SolarTrackers/SolarTrackerProject/README.md

# SolarTrackerProject
We are two student at Polytech Orleans, we created a solar tracker from scratch
