SolarTrackers/SolarTrackerProject/Final presentation 26 Avril 2024.pdf

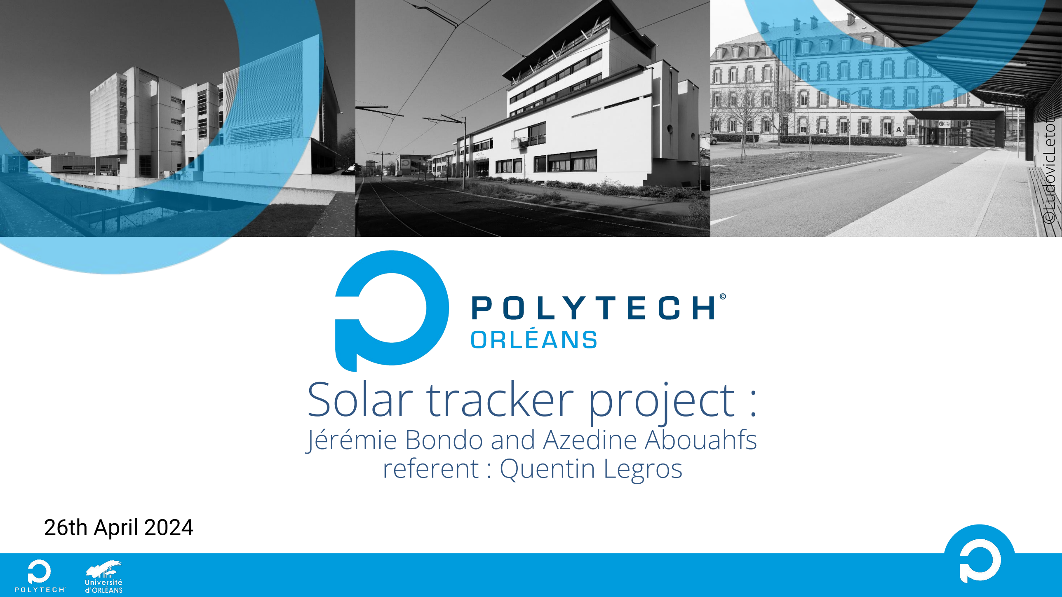
[picture p1: page 1]

1

## ©LudovicLetot

## 26th April 2024

# Solar tracker project :

# Jérémie Bondo and Azedine Abouahfs referent : Quentin Legros

2

## Friday 26th April 2024

# Contents

# -Project’s summary

# -Technical part

# -Technical solutions

# - Involvement of each member

# -Conclusion

# -Demonstration

# Context

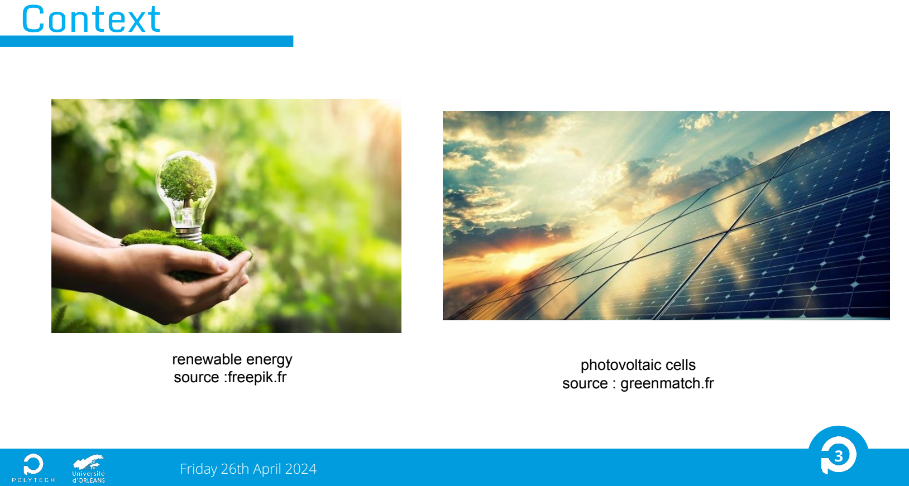
[picture p2: page 3]

3

photovoltaic cells
source : greenmatch.fr

renewable energy
source :freepik.fr

# Contexts

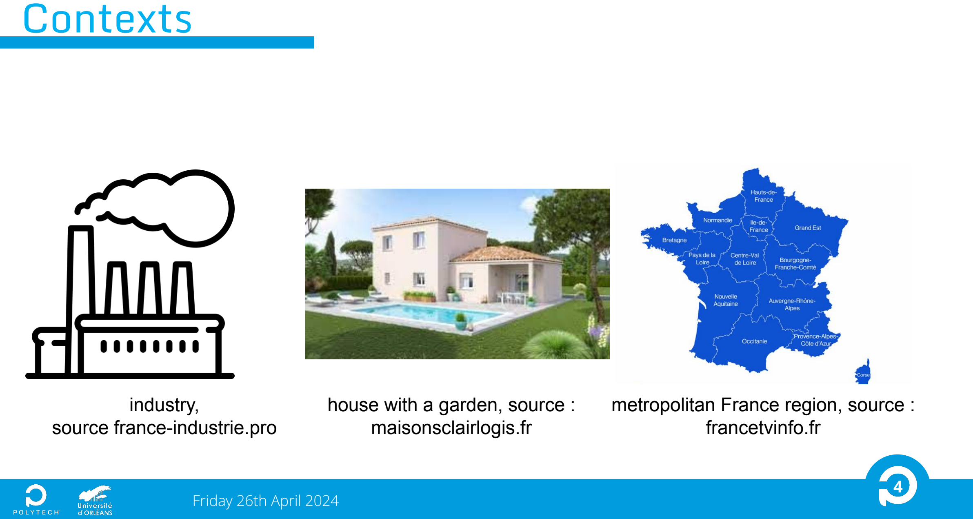
[picture p3: page 4]

4

industry,

### source france-industrie.pro

### metropolitan France region, source : francetvinfo.fr

### house with a garden, source : maisonsclairlogis.fr

5

# Last year project

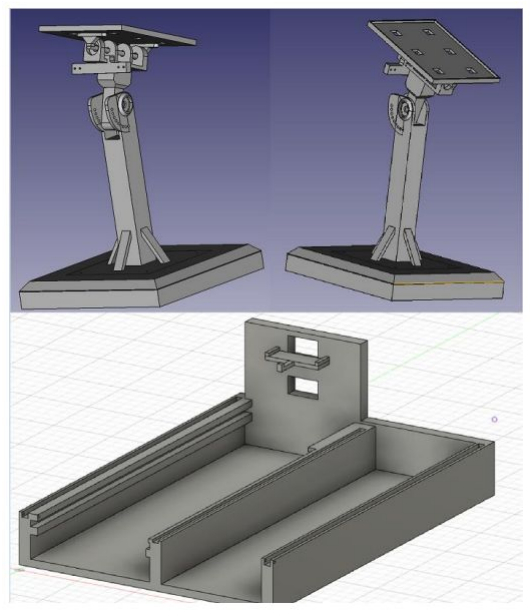
[picture p4: figure]

### view of the 3D models of the 2022-2023 solar tracker project group

# We were able to recover their : -documents - photovoltaic cells

- tracker.

6

# Objectives

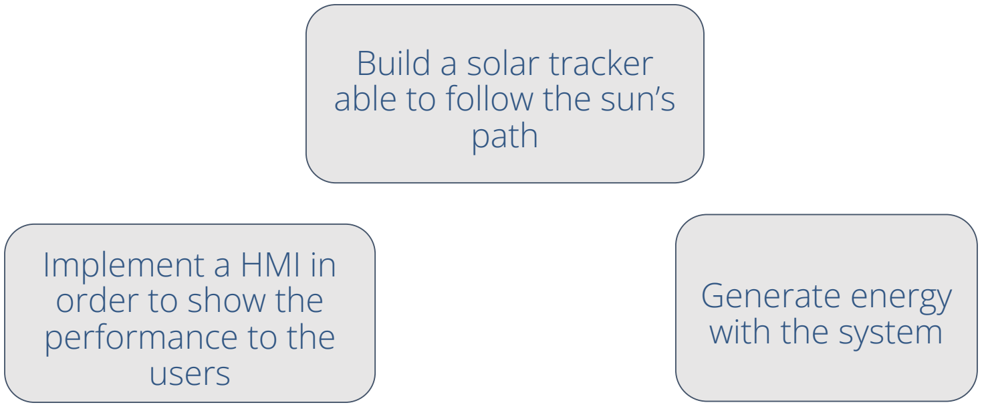
[picture p5: figure]
Build a solar tracker able to follow the sun’s path; Generate energy with the system; Implement a HMI in order to show the performance to the users
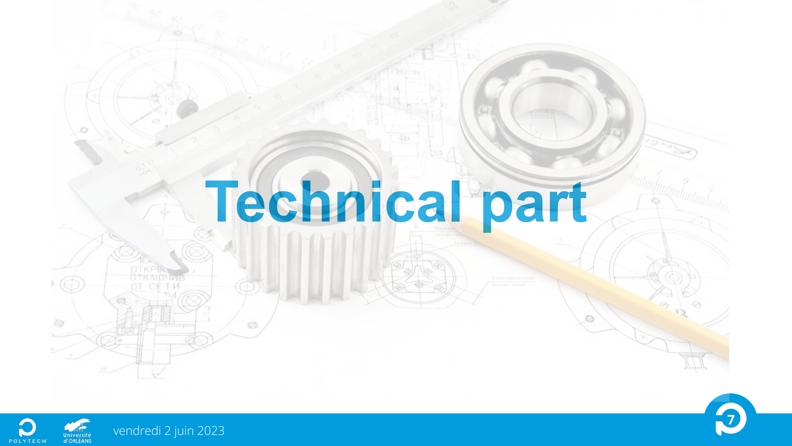
[picture p6: page 7]

7

## vendredi 2 juin 2023

# Technical part

8

# Technical part : What is a solar tracker

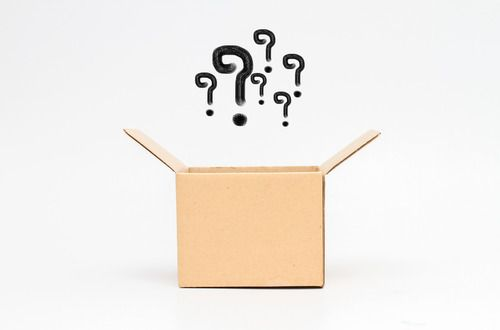
[picture p7: figure]

### mediascol.al

9

# Technical part : What is a solar tracker

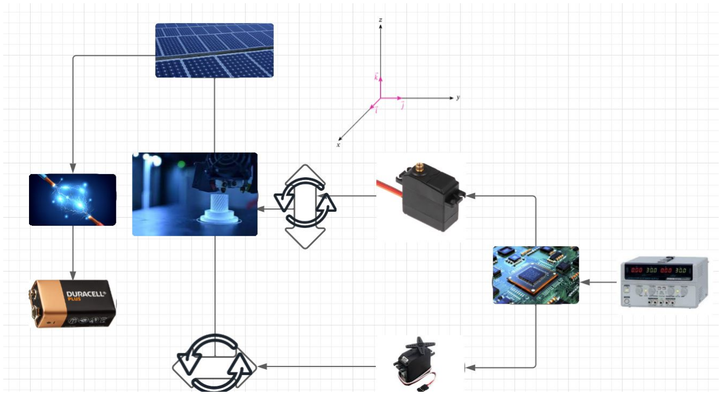
[picture p8: figure]

10

# Features of our project

Features | Assessment criteria

Level of
appreciation

Acceptation
limit
Tracking Precision | - Angle of rotation | 110 degrees around the West/East axis | ± 5 degrees
Energy Production | - Performance of the cells | 0,5W/panel | -0,15W/panel
Resists to challenging weather conditions | -snow, rain, wind -temperature -humidity | -5°C - 40°C 40% - 70%

Ease of Installation
and control
- Datasheet

Carry/Protect the
sensors and the
microcontroller
- Structural
stability
- Durability

PLA

6 months -1year

# Technical Solutions : Measures

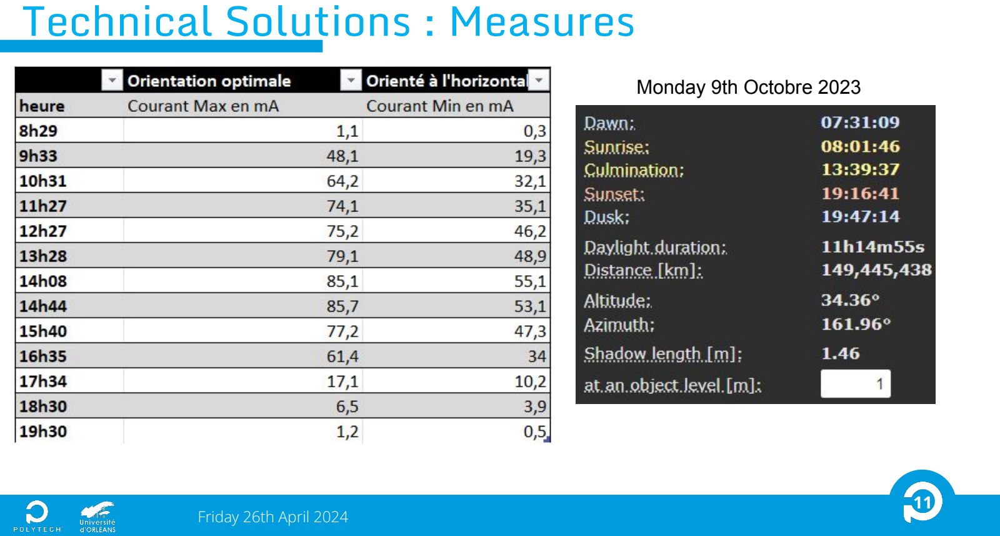
[picture p9: page 11]

11

### Monday 9th Octobre 2023

12

# Technical solutions

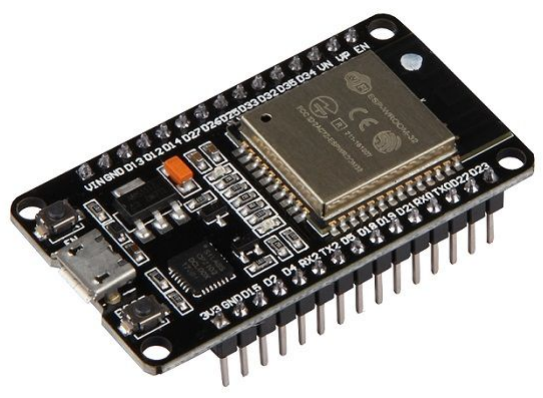
[picture p10: figure]

Esp32

Power supply | 5V-3,3 V
Consumption | Max 50mA

Programming
language

C/C++

Price | 12€
Weight | 7g

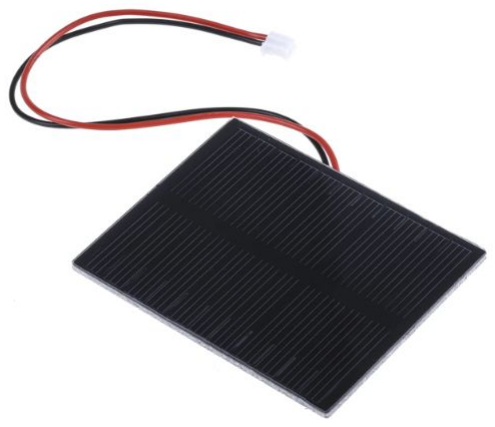
[picture p11: figure]

Photovoltaic plates

Power rating | 0.5W
Current | 100 mA
Dimensions | 70x55x3mm
Price | 3,3€
Weight | 20g

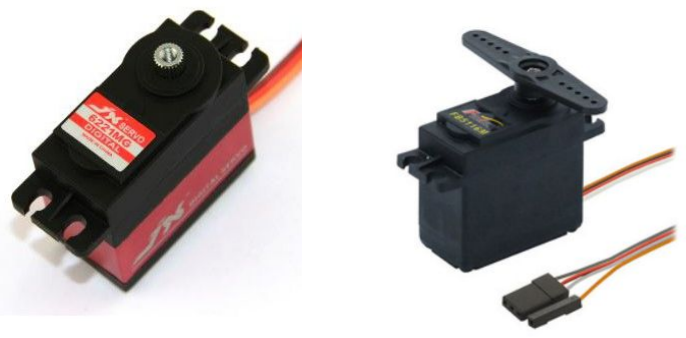
[picture p12: figure]

Servomoteur

Tension | 4,8 - 6,6V
Torque | 15kg.cm | 10kg.cm

Rotation
angle
180° | 280°
Price | 17€ | 14,65€
Weight | 50g | 65

# Components

Figure : esp32 (gotronic.fr) | Figure : Photovoltaic plates
(Seeedstudio.com)

Figure : Servo-Motor
(Robot-maker.com)

Servo-Motor, source :

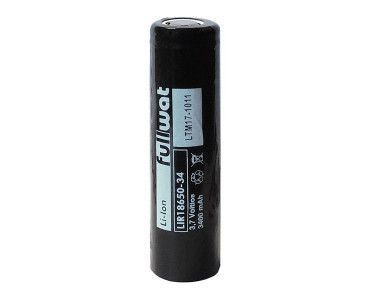
[picture p13: figure]

Figure : Battery LI-ION | go-tronic.com
(Go-tronic.fr)

Battery Li-Ion

Tension | 3,7V
Capacity | 3400 mAh
Type | Lithium-Ion
Rechargeable | Yes
Weight | 46g

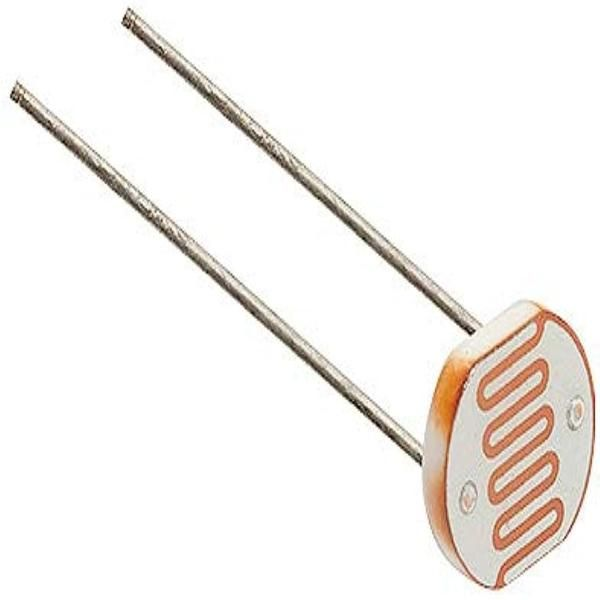
[picture p14: figure]

13

# Technical solutions

# Components

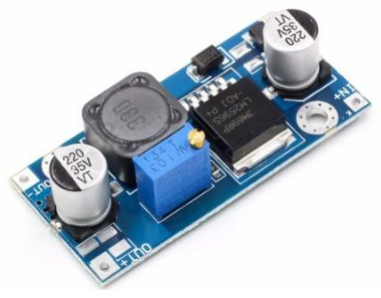
[picture p15: figure]

Voltage regulator DC-DC

Input Voltage | 3,2V - 42V
Output Voltage | 1,25V -35V
Output current | 3A (Max)
Rendement | 92%
Price | 0,6€

Ball bearing

Inside diameter 60 mm

outside
diameter

### 95 mm

Price | 19.34€
Weight | 200g

Figure : Ball bearing (rs-online)

Figure : Voltage regulator (Aliexpress.com)

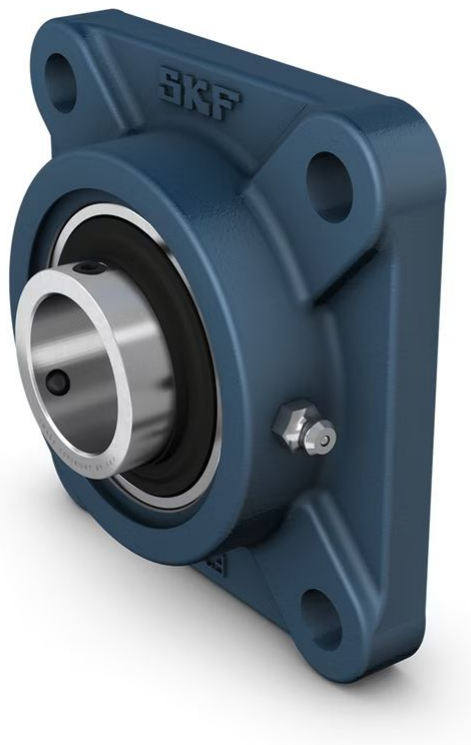
[picture p16: figure]

Ball bearing 2

Inside
diameter

### 12 mm

outside
diameter

### 26 mm

Price | 19 €
Weight | 30g

Figure : Ball bearing (SKF.com) Figure : light sensor
(go-tronic.com)

light dependant resistor

Weight | 7g

14

# Technical solutions : Human Machine Interface

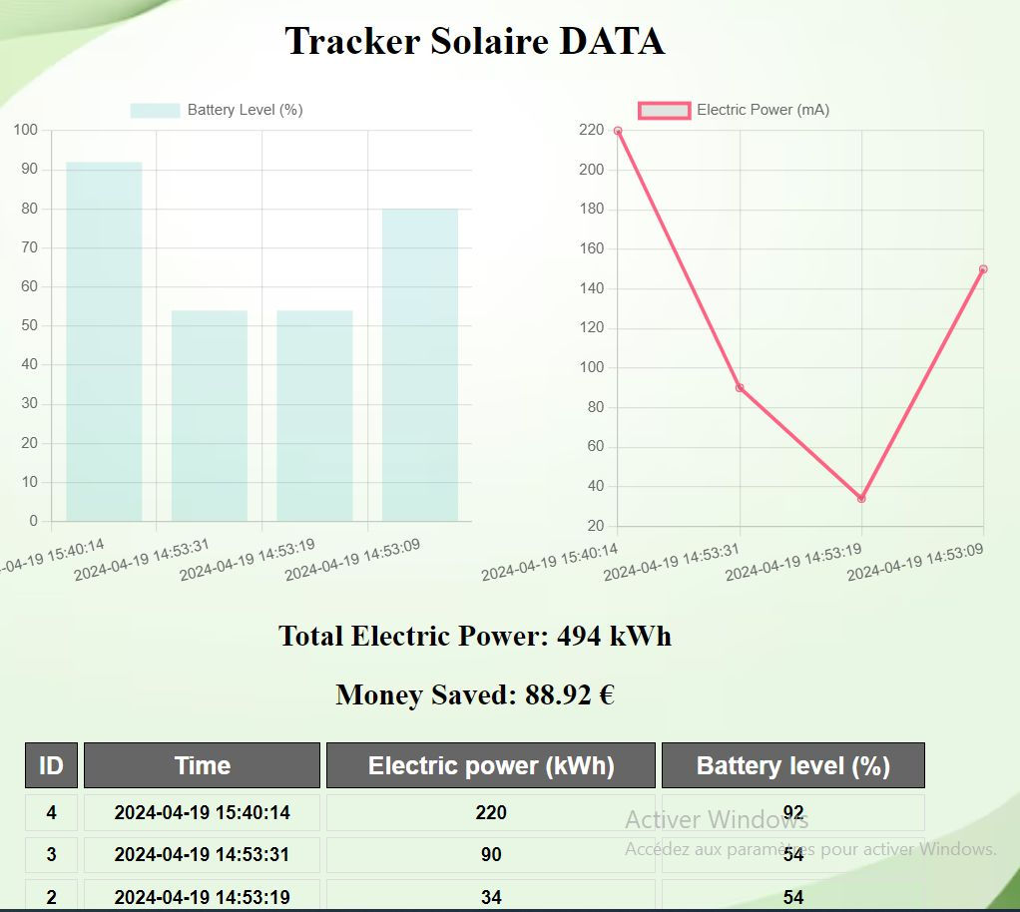
[picture p17: figure]

### graphical interface on a PC

# Human Machine Interface (HMI)

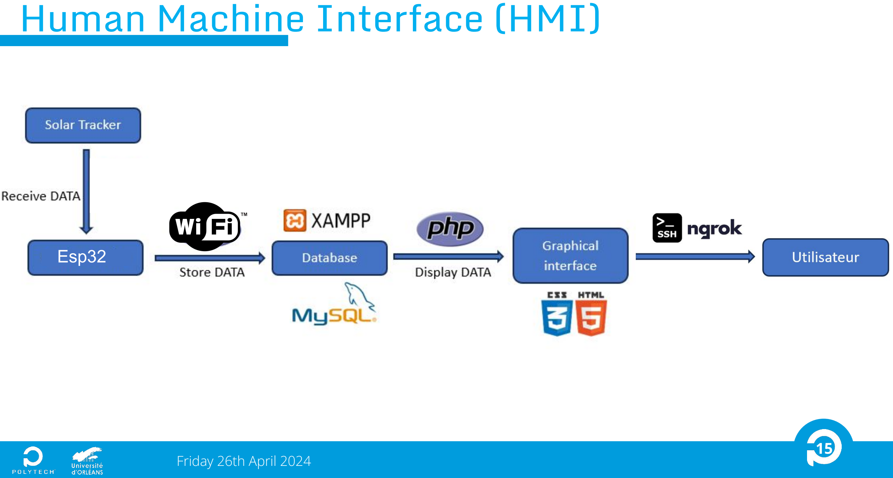
[picture p18: page 15]

15

### Esp32

# Technical solutions : The support

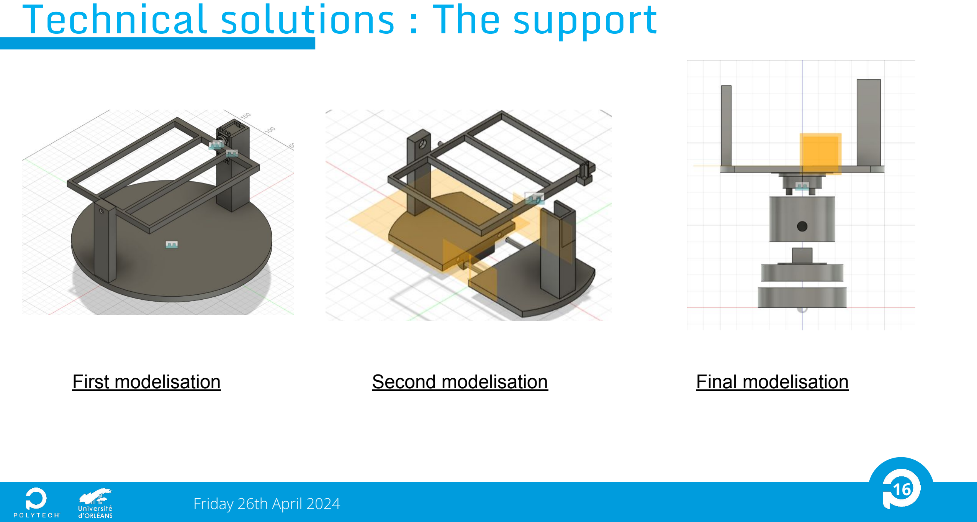
[picture p19: page 16]

16

First modelisation | Second modelisation | Final modelisation

# Technical solutions: The support

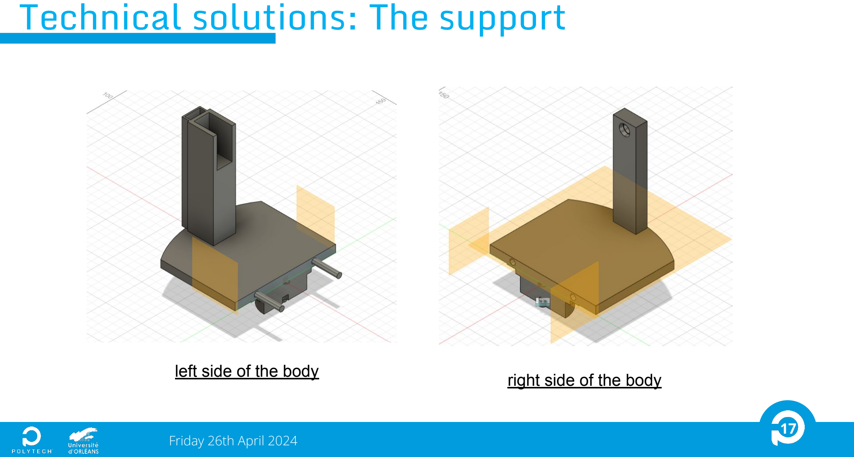
[picture p20: page 17]

17

left side of the body | right side of the body

# Technical solutions: The support

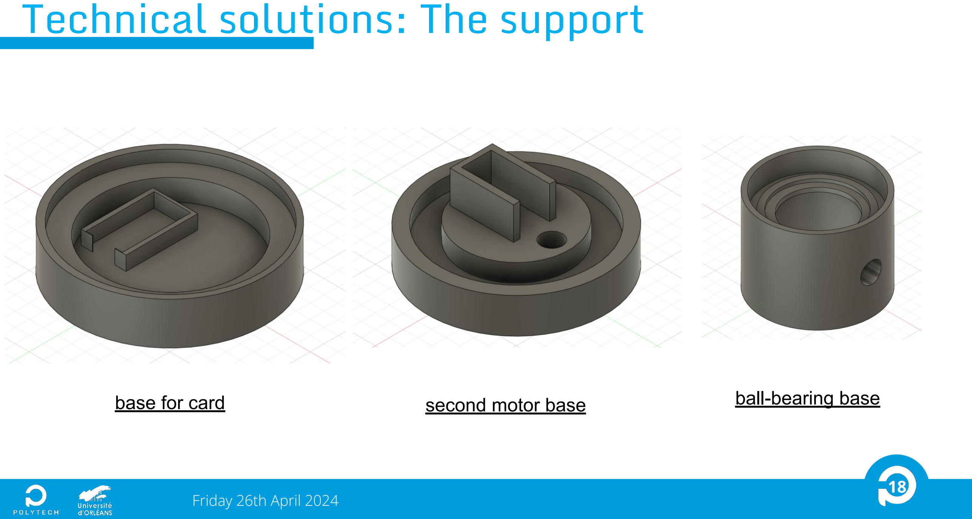
[picture p21: page 18]

18

base for card | second motor base | ball-bearing base

# Technical solutions : coding

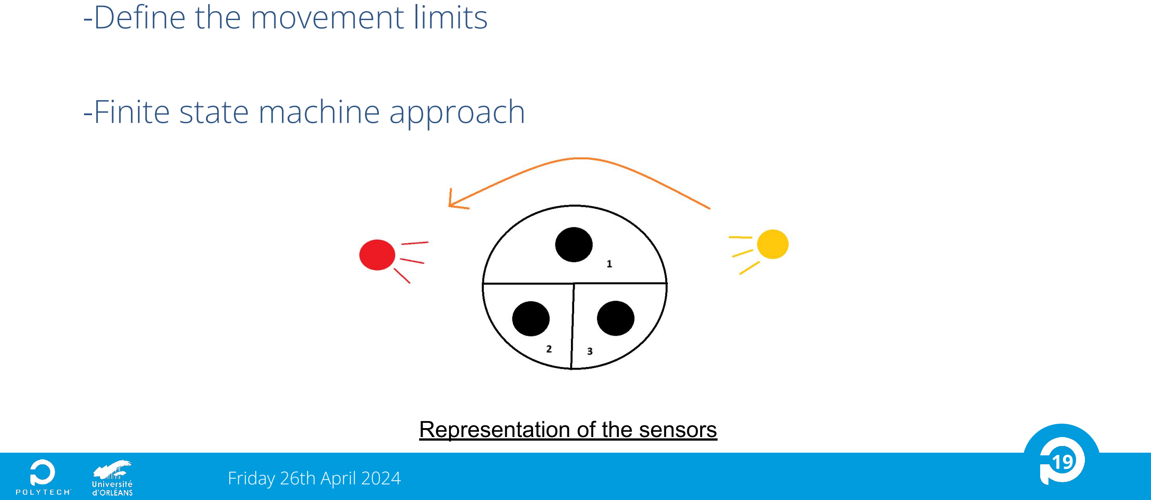
[picture p22: figure]
-Define the movement limits; -Finite state machine approach; Representation of the sensors

20

# Technical solutions : coding

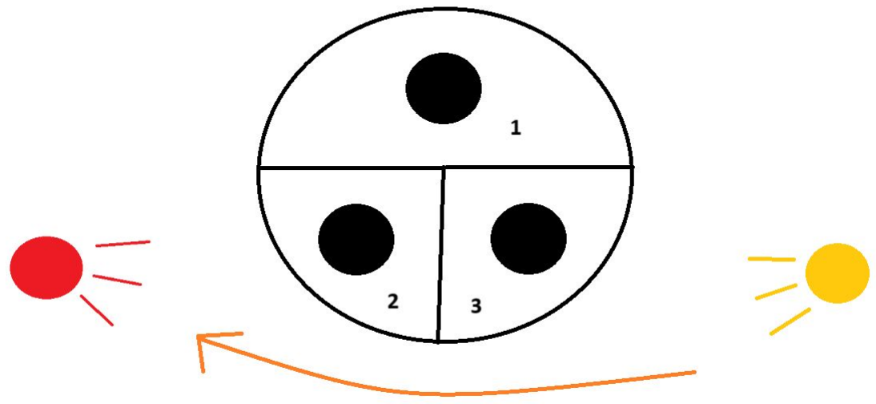
[picture p23: figure]
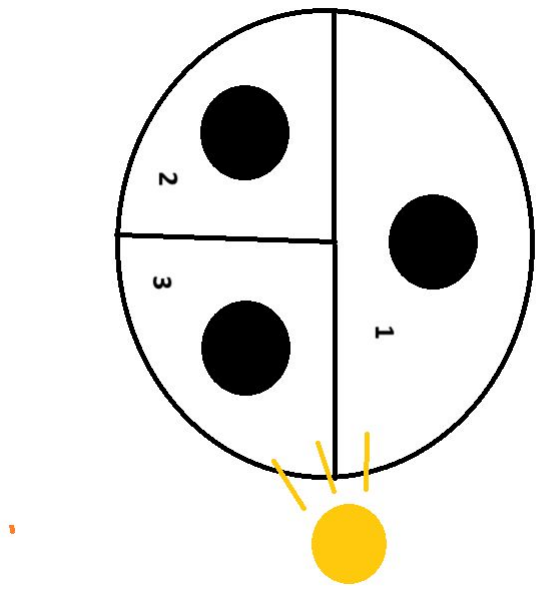
[picture p24: figure]

sun’s inclinaison in winter | The rotation in order to be align

21

# The cost of our project excluding labor

Designation | Quantity | Unit price (euros) | Total
Photovoltaic cells | 12 | 1,95 | 23,4
Raspberry pico | 1 | 9,5 | 9,5
Servo-motor 1 | 1 | 17 | 17
Servo-motor 2 | 1 | 14,65 | 14,65
Voltage regulator | 1 | 0,65 | 0,65
Ball Bearing 1 | 1 | 19.34 | 19,34
Ball Bearing 2 | 1 | 5.24 | 5.24
3D printing | 40 | 2 | 80
Total | | | | 169.78 euros

22

# Expected results

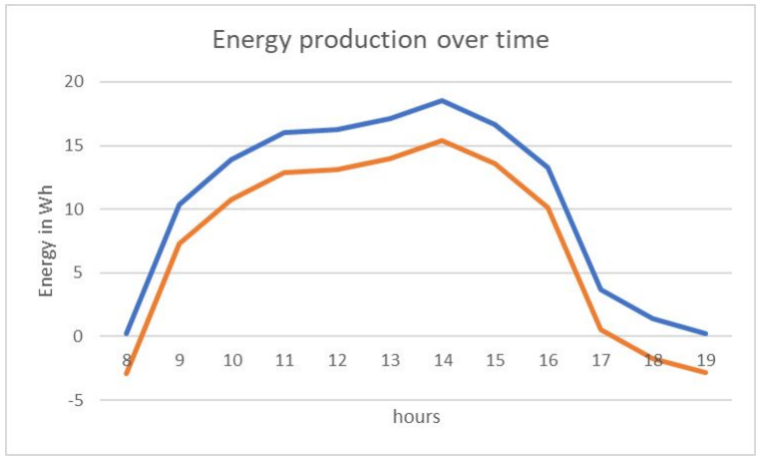
[picture p25: figure]

### Over the course of a day : 24,961 W

### Cost of the tracker : 169.78 euros Fixed price of a kWh in France : 0.2561 euros

### Profitable after 74 years …

23

# Comparison with others trackers

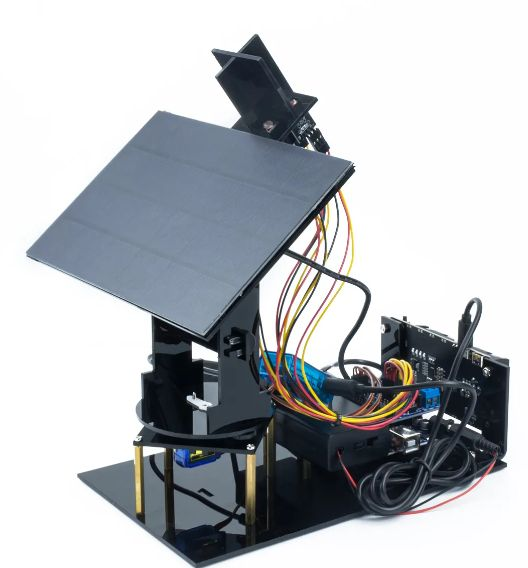
[picture p26: figure]
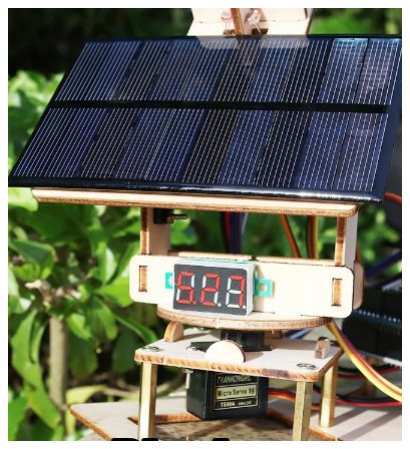
[picture p27: figure]

Solar tracker | Aliexpress | Alibaba
Price | 40 euros | 35,7 euros

24

## vendredi 2 juin 2023

# What if we build the same tracker at a bigger scale?

25

# Comparison with others trackers

## Characteristics

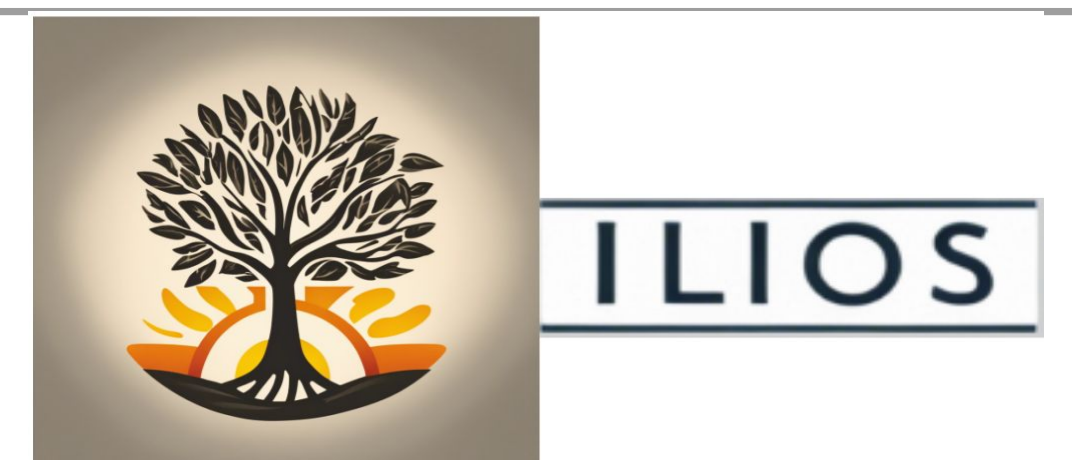
[picture p28: figure]

Price | 12000 € | 1321 € | 2000 €
Area of the photovoltaic cells | 7,2 m2 | 7 m2 | 7,48 m2
Tracking | Yes (2 axis) | No | Yes (2 axis)
HMI | Yes | No | Yes
Installation | Yes | No | No

26

# Our tracker at a bigger scale

quantity | unit price | mass (kg) | total (euros)
photovoltaic cells | 4 | 65 | 24 | 260
motor 1 | 1 | 9.58 | 0.110 | 9.58
motor 2 | 1 | 27.34 | 0.60 | 27.34
aluminium | 80 | 0,3 | 80 | 24
tracking | 1 | 10 | 2 | 10
Manufacturing | 1 | 120 | | 120
transport | 1 | 150 | 150
ball bearings | 1 | 14.74 | 0.116 | 16.56
microcontroller | 1 | 20 | 0.020 | 20
regulator | 1 | 5 | 0.146 | 5
total | | | | 605.56
Quantity | unit price | sells
10 | 2000 | 20000
50 | 2000 | 100000
100 | 2000 | 200000
Quantity | Cost
10 | 6055,6
50 | 30278
100 | 60556

Profit and taxes
Quantity | Profit (euros) | taxes (euros)
10 | 13944,4 | 10067,85
50 | 69722 | 50339,28
100 | 139444 | 100678,56
Taxes
Amazon | 15%
social contributions | 12,80%

27

# Expected results

| Little Solar Tracker | Big Solar Tracker
hours | Energy produced (Wh)
8 am | 5,5 | 20,79
9 am | 240,5 | 909,24
10 am | 321 | 1213,58
11 am | 370,5 | 1400,72
12 am | 376 | 1421,51
1 pm | 395,5 | 1495,23
2 pm | 428,5 | 1620
3 pm | 386 | 1459,32
4 pm | 307 | 1160,65
5 pm | 85,5 | 323,24
6 pm | 32,5 | 122,87
7 pm | 6 | 22,68

### Production over the course of a day of the big tracker : 11,1kW

### Return of investment over : 1.9 years

28

# Involvement of each member

Objectives | Jérémie | Az-eddine
Schedule the development of the project | 100%
Command the pieces | 50% | 50%
Choose and start the construction of the Modelisation | 100%
Establishment of the human machine interface | | 100%
Testing and Soldering Electronic Components | | 100%
writing the technical file | 100%

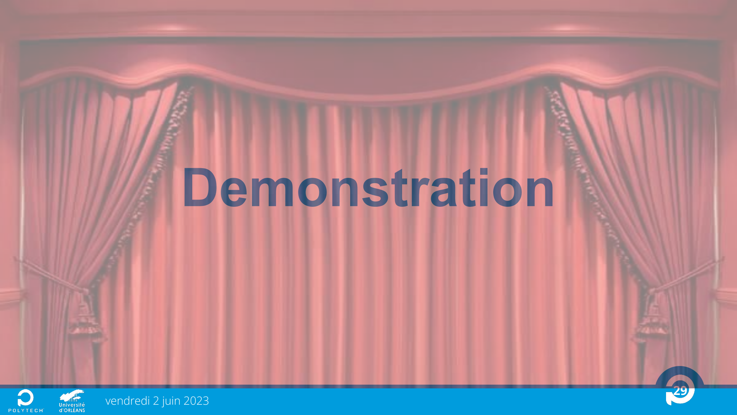
[picture p29: page 29]

29

## vendredi 2 juin 2023

# Demonstration

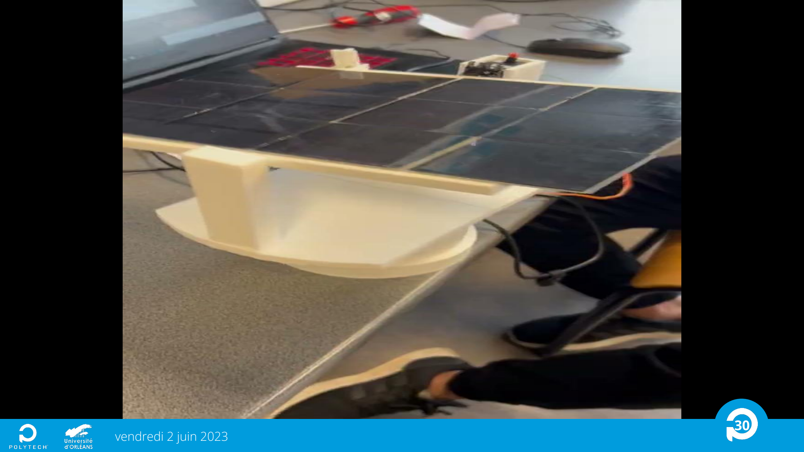
[picture p30: page 30]

30

## vendredi 2 juin 2023

[Mettre la vidéo ici] (https://docs.google.com/file/d/1Eoy0Z42zPEi8TMftUHMfzo145T48u9Uc/preview)

31

# Conclusion : skills acquired

# - 3D modelisation on Vision 360 - Project management (Gantt project) - Mechanical forces calcultation - Computing in database - Capella - 3D impression with two printers

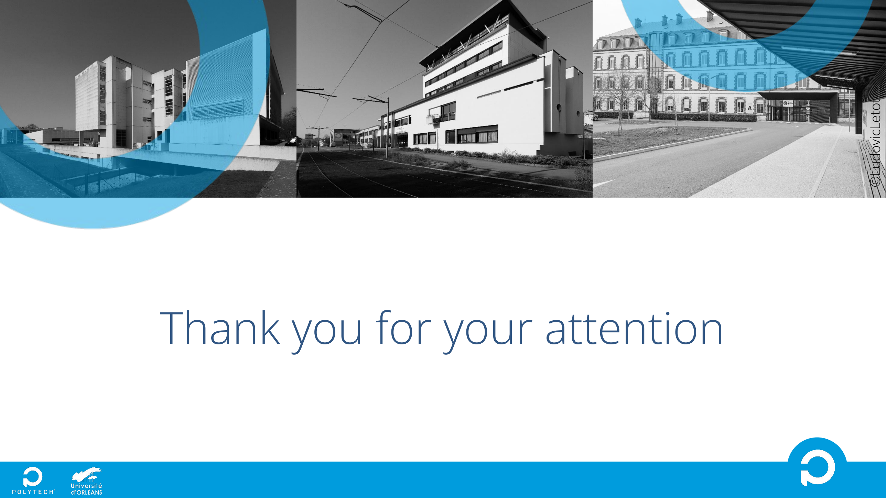
[picture p31: page 32]

32

## ©LudovicLetot

# Thank you for your attention
