SolarTrackers/SolarTrackerProject/Poster.pdf

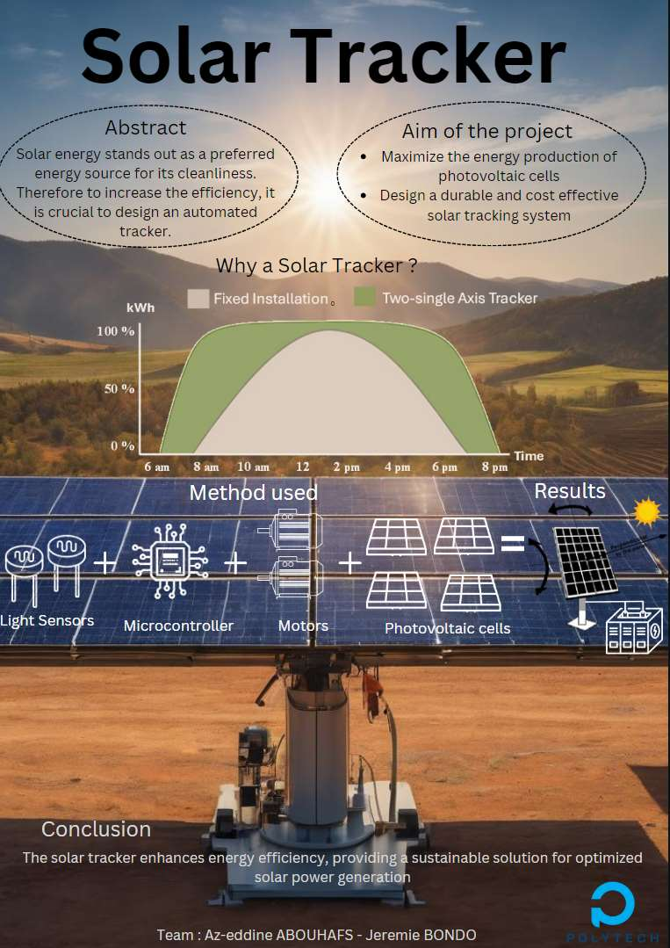
[picture p62: page 1]
