SolarTrackers/SolarTrackerProject/3D impression/Corps_moitie_droite v4.stl

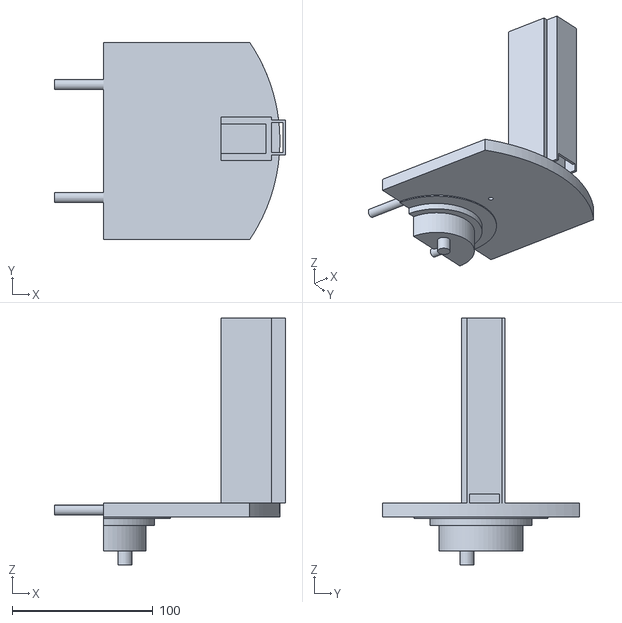
[picture p63: CAD file, 2024-09-09]
3D impression/Corps_moitie_droite v4.stl
164.1 x 140.0 x 175.2
