SolarTrackers/SolarTrackerProject/3D impression/Socle VF v4.stl

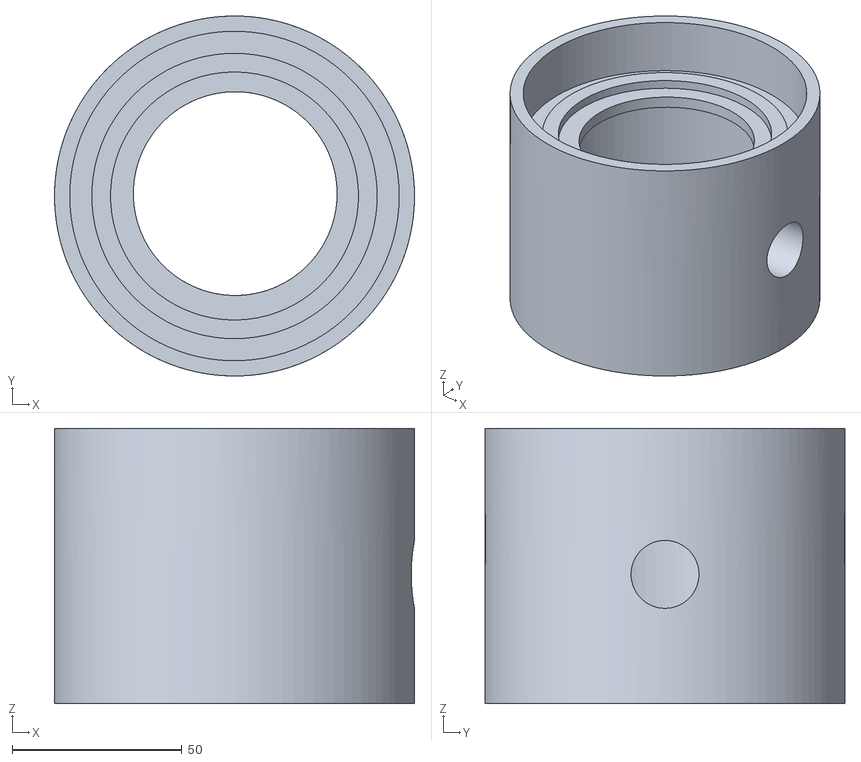
[picture p64: CAD file, 2024-04-29]
3D impression/Socle VF v4.stl
106.0 x 106.0 x 81.0
