SolarTrackers/SolarTrackerProject/3D impression/Socle_part2 v6.stl

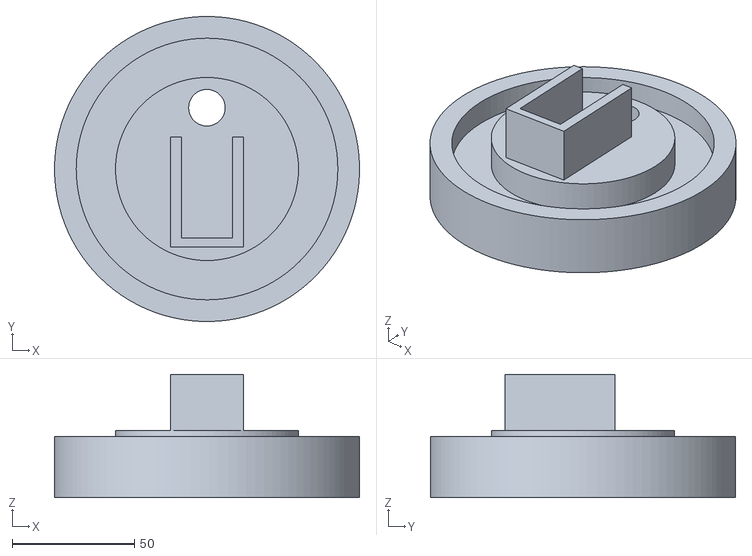
[picture p65: CAD file, 2024-04-29]
3D impression/Socle_part2 v6.stl
125.0 x 125.0 x 50.5
