SolarTrackers/SolarTrackerProject/3D impression/Socle part 3 v1.stl

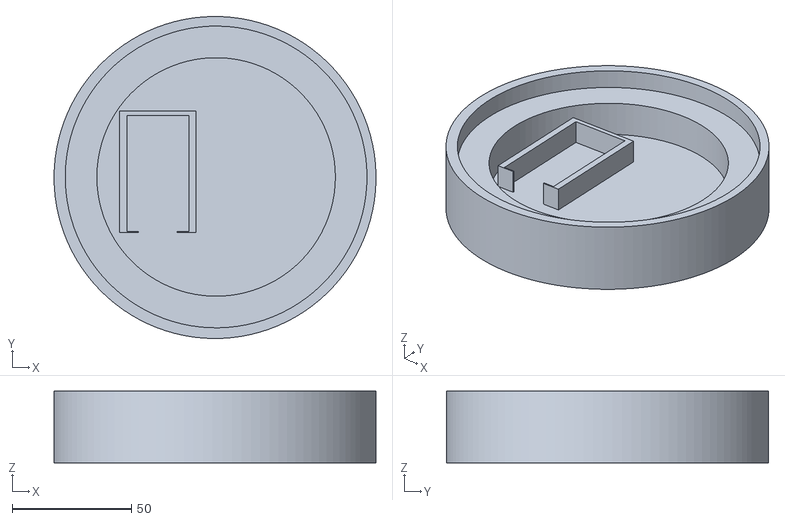
[picture p66: CAD file, 2024-04-29]
3D impression/Socle part 3 v1.stl
135.0 x 135.0 x 30.0
