SolarTrackers/SolarTrackerProject/3D impression/Corps_moitie_gauche v5.stl

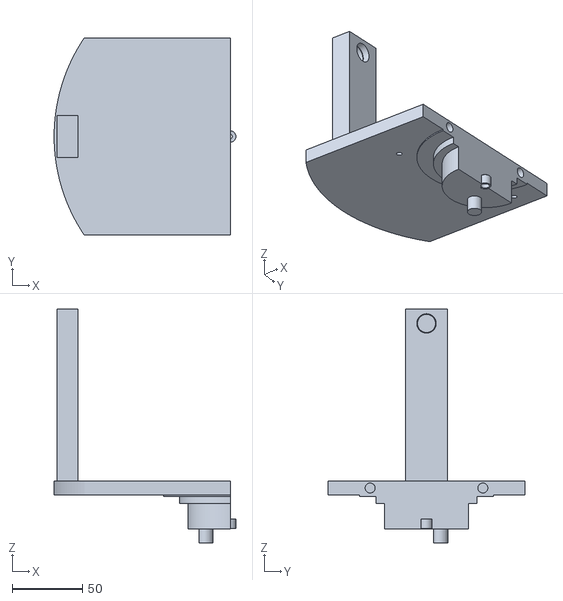
[picture p67: CAD file, 2024-04-29]
3D impression/Corps_moitie_gauche v5.stl
129.0 x 140.0 x 166.0
